DAVO2801/transmision-luz-invisible-morse/docs/Marco_Teorico_Luz_Invisible_Morse.docx

MARCO TEÓRICO: TRANSMISIÓN DE INFORMACIÓN MEDIANTE LUZ INVISIBLE

INTEGRANTES

Juan Felipe Orozco

Daniel Villegas Toro

Juan Miguel Gómez

DOCENTE

Mateo Cardona Marin

ASIGNATURA

TEORÍA DE SEÑALES

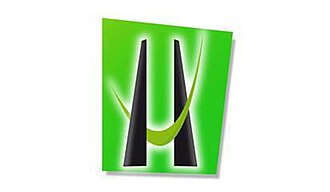
[picture p1: figure]

UNIVERSIDAD DE MANIZALES

1. Resumen del Proyecto

El presente proyecto aborda el estudio, diseño y evaluación práctica de un sistema de comunicación por luz invisible, en el que la información se transmite mediante radiación infrarroja (IR) emitida por un control remoto convencional. Cada pulsación del control corresponde a un símbolo del código Morse: una pulsación corta representa un punto y una pulsación larga representa una raya. La señal infrarroja es captada por un módulo receptor IR (VS1838B / TSOP1838) conectado a un microcontrolador Arduino, que mide la duración de cada pulsación, decodifica los caracteres y muestra el mensaje en una pantalla LCD de 16x2.

La luz emitida por el control se encuentra modulada sobre una portadora de 38 kHz, y el receptor incorpora un filtro pasabanda y un demodulador que solo responden a esa frecuencia. Esto permite estudiar en la práctica conceptos de Teoría de Señales como la modulación, el filtrado, la demodulación y la inmunidad al ruido óptico ambiental. A través de este trabajo se pretende evaluar la precisión en la decodificación del código Morse, el tiempo de respuesta del sistema, el alcance y el ángulo de recepción, y el efecto de la luz ambiental sobre la comunicación.

2. Objetivo a Lograr

Diseñar, implementar y evaluar experimentalmente un prototipo funcional de transmisión y recepción de información mediante luz infrarroja (invisible), en el que las pulsaciones de un control remoto se interpretan como código Morse y el mensaje decodificado se visualiza en una pantalla LCD, determinando su precisión, alcance y robustez frente a la luz ambiental en entornos controlados.

Objetivos específicos

- Implementar en Arduino la detección de la señal infrarroja y la medición de la duración de cada pulsación del control remoto.

- Clasificar las pulsaciones en puntos y rayas y decodificar letras, números y signos del código Morse internacional.

- Mostrar en tiempo real el mensaje decodificado en una pantalla LCD 16x2.

- Medir la tasa de acierto, el alcance máximo, el ángulo de recepción y el efecto de la luz ambiental sobre el sistema.

3. Definiciones de Palabras Asociadas

Luz invisible (radiación infrarroja): Radiación electromagnética cuya longitud de onda es mayor que la del espectro visible (aproximadamente de 700 nm a 1 mm), imperceptible para el ojo humano. Los controles remotos emiten normalmente en torno a 940 nm.

LED infrarrojo: Diodo emisor de luz que emite radiación infrarroja. Es la fuente óptica del control remoto.

Control remoto infrarrojo: Dispositivo que codifica la pulsación de cada botón como una trama digital (por ejemplo, con el protocolo NEC) y la transmite mediante destellos de un LED infrarrojo.

Portadora de 38 kHz: Señal periódica de alta frecuencia sobre la que se modula la información. Durante cada ráfaga, el LED se enciende y apaga 38.000 veces por segundo, lo que permite distinguir la señal útil de la luz ambiental.

Receptor IR (VS1838B / TSOP1838): Módulo que integra un fotodiodo, un amplificador, un filtro pasabanda centrado en 38 kHz y un demodulador. Entrega una señal digital que indica la presencia o ausencia de la portadora.

Protocolo NEC: Protocolo de control remoto en el que cada pulsación genera una trama de 32 bits (dirección y comando). Mientras el botón se mantiene presionado, se envía un código de repetición aproximadamente cada 110 ms.

Código Morse: Sistema de representación de letras y números mediante señales intermitentes de duración variable: puntos (.) y rayas (-).

Modulación OOK: Técnica de modulación digital por desplazamiento de amplitud en la que la presencia de la señal representa un estado alto (pulso) y su ausencia un estado bajo (espacio).

Demodulación: Proceso de recuperar la información original a partir de la señal modulada. En este proyecto la realizan el receptor IR (elimina la portadora) y el Arduino (interpreta la duración de las pulsaciones).

Pantalla LCD 16x2 con I2C: Pantalla de cristal líquido de 2 filas y 16 caracteres que se comunica con el Arduino mediante el bus I2C, usando solo dos líneas de datos (SDA y SCL).

Relación señal/ruido: Proporción entre la potencia de la señal útil y la del ruido de fondo. En este sistema el ruido proviene principalmente de la luz solar y de las lámparas.

4. Antecedentes de Investigación

- Gómez, M., & Rodríguez, F. (2023). Análisis de rendimiento de sistemas Li-Fi en entornos interiores con interferencia de luz ambiental. Revista Iberoamericana de Telecomunicaciones, 15(2), 45-58.

- Haas, H., & Chen, C. (2022). Advances in high-speed visible light communication using micro-LED arrays. IEEE Transactions on Wireless Communications, 21(8), 6102-6115.

- Martínez, J., López, E., & Torres, R. (2024). Prototipado de bajo costo para transmisión de audio analógico mediante comunicación por luz visible. Journal of Applied Optics and Electronics, 9(1), 12-24.

- Kahn, J. M., & Barry, J. R. (1997). Wireless infrared communications. Proceedings of the IEEE, 85(2), 265-298.

- International Telecommunication Union. (2009). Recommendation ITU-R M.1677-1: International Morse code. ITU-R.

- Vishay Semiconductors. TSOP382.., TSOP384.. IR Receiver Modules for Remote Control Systems [Hoja de datos].

- Joachimsmeyer, A., et al. Arduino-IRremote [Software]. GitHub. https://github.com/Arduino-IRremote/Arduino-IRremote

5. Materiales

Emisor óptico: Control remoto infrarrojo (protocolo NEC, como el incluido en los kits de Arduino), que emite luz infrarroja de aproximadamente 940 nm modulada a 38 kHz.

Receptor óptico: Módulo receptor IR VS1838B / TSOP1838 (o módulo KY-022), con filtro de 38 kHz y salida digital.

Control y procesamiento: Microcontrolador Arduino Uno.

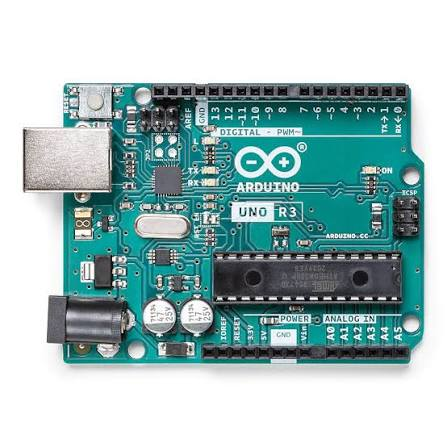
[picture p2: figure]

Visualización: Pantalla LCD 16x2 con módulo adaptador I2C (dirección 0x27 o 0x3F).

Componentes varios: Protoboard, cables jumper, cable USB, y buzzer activo y LED indicador (opcionales).

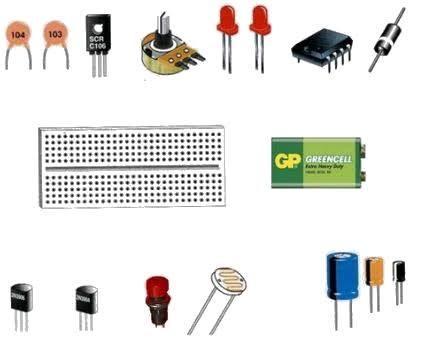
[picture p3: figure]

Software: Arduino IDE 2 con las librerías IRremote (versión 4.x) y LiquidCrystal I2C.

6. Desarrollos

6.1 Arquitectura del sistema

El sistema se compone de tres etapas: (1) emisión, en la que el control remoto convierte cada pulsación en ráfagas de luz infrarroja moduladas a 38 kHz; (2) recepción y demodulación, en la que el módulo VS1838B filtra la portadora y entrega una señal digital; y (3) procesamiento y visualización, en la que el Arduino mide la duración de cada pulsación, la traduce a código Morse y presenta el texto en la pantalla LCD.

6.2 Conexiones

- Receptor IR: OUT al pin digital 2; VCC a 5 V; GND a GND.

- Pantalla LCD I2C: SDA al pin A4; SCL al pin A5; VCC a 5 V; GND a GND.

- Buzzer activo (opcional): terminal positivo al pin digital 8; terminal negativo a GND.

6.3 Algoritmo de decodificación

- Mientras el botón permanece presionado, el control envía tramas de repetición cada 110 ms aproximadamente. El Arduino considera que el botón se soltó cuando pasan más de 160 ms sin recibir señal.

- Si la pulsación dura menos de 300 ms se interpreta como punto (.); si dura más, como raya (-).

- Un silencio de 800 ms indica el fin de la letra: la secuencia de símbolos se compara con la tabla del código Morse internacional y el carácter se muestra en la primera fila de la LCD.

- Un silencio de 2,5 s inserta un espacio entre palabras. La segunda fila de la LCD muestra los símbolos que se están ingresando y la letra que formarían.

- Tres botones del control se reservan como funciones: insertar espacio, borrar el último carácter y limpiar la pantalla.

- Los tiempos anteriores son parámetros del programa y pueden ajustarse según la destreza del usuario.

6.4 Plan de pruebas

- Precisión: transmitir mensajes de prueba (por ejemplo, "SOS" y "HOLA MUNDO") y calcular el porcentaje de caracteres decodificados correctamente.

- Alcance: repetir la transmisión aumentando la distancia cada 0,5 m hasta que la decodificación falle.

- Ángulo de recepción: medir la recepción variando el ángulo entre el control y el receptor.

- Luz ambiental: comparar el desempeño en oscuridad, con luz artificial y con luz solar directa.

- Tiempo de respuesta: registrar en el Monitor Serie la duración medida de cada pulsación.

7. Conclusiones
