DAVO2801/transmision-luz-invisible-morse/(commit log)

2026-10-05 Proyecto: transmisión de Morse por láser infrarrojo
    Sketches de emisor y receptor para Arduino, README con conexiones y
    materiales, y el marco teórico del proyecto.
2026-10-08 Nueva versión: Morse con control remoto IR y pantalla LCD
    - Sketch morse_ir_lcd: receptor VS1838B + IRremote, pulsación corta/larga
    como punto/raya, decodificación y visualización en LCD 16x2 I2C.
    - Versión con láser movida a version_laser/.
    - Marco teórico y README actualizados a la nueva propuesta.
2026-10-19 Agregar bitácora del proyecto
    Historia del proyecto, montaje paso a paso, uso, problemas encontrados
    y guía para la exposición.
2026-10-26 Agregar transmisor Bluetooth y guia de armado
    - transmisor_bt_morse: recibe texto por HC-05 y lo emite en Morse con
    LED IR a 38 kHz hacia el receptor existente.
    - Guia de armado de los dos Arduinos (PDF en docs/).
    - morse_ir_lcd: boton extra que dibuja un corazon en la LCD.
    - README y BITACORA actualizados.
2026-11-05 Transmisor: LED visible testigo en D4
    Se enciende junto con el LED infrarrojo en cada punto y raya, para
    verificar la transmision a simple vista sin usar la camara.
2026-11-05 Actualizar documentacion: LED testigo, montaje del transmisor y pruebas
    - BITACORA: seccion de montaje del transmisor (HC-05, divisor, LED IR,
    LED testigo), uso por Bluetooth, nuevos problemas resueltos y fechas.
    - Guia de armado (PDF): paso del LED testigo y notas de carga de codigo.
    - README: nota del LED testigo y envio por Monitor Serie.
2026-11-08 Agregar app Android MorseVoz (voz por BLE) y afinar tiempos del transmisor
    - app_morsevoz: app nativa Kotlin (voz -> texto -> Bluetooth LE al modulo),
    codigo fuente, manifiesto, layout y APK listo para instalar.
    - transmisor_bt_morse: tramas NEC completas en vez de codigos de repeticion
    para que las rayas se decodifiquen bien; raya a 550 ms.
    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
